TaylorHerndon/ModularI2CBoard_Spring2022/Circuit Information/SensorBoard.pdf

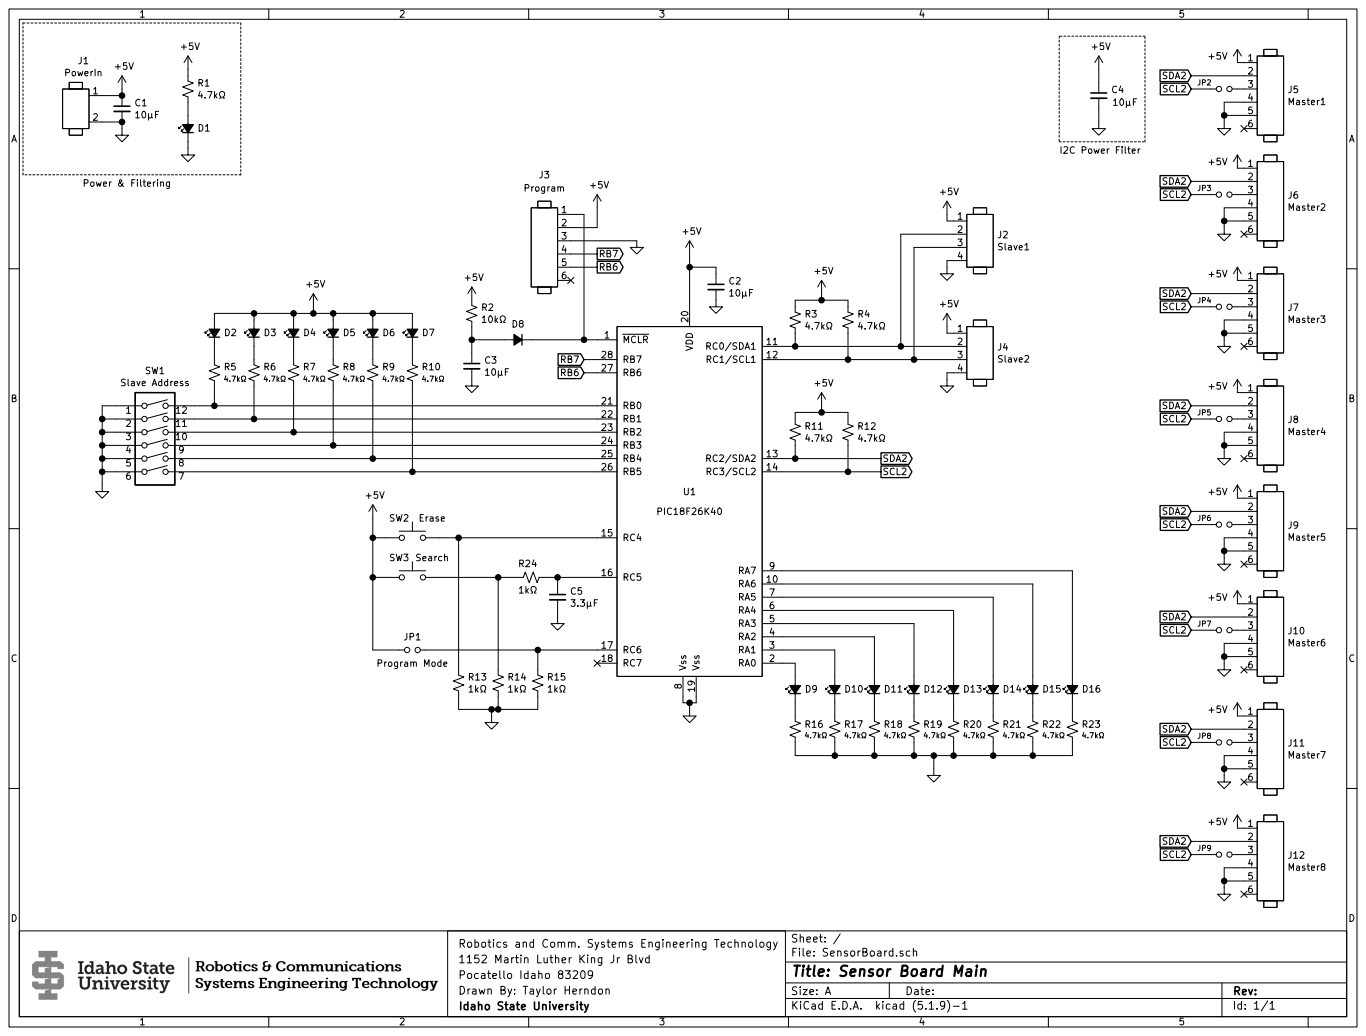
[picture p3: page 1]

I2C Power Filter Power & Filtering

File: SensorBoard.sch Sheet: /
Id: 1/1 Title: Sensor Board Main

1152 Martin Luther King Jr Blvd
Drawn By: Taylor Herndon Pocatello Idaho 83209
