TaylorHerndon/ModularI2CBoard_Spring2022/Circuit Information/SensorBoard/Back Silk Screen.pdf

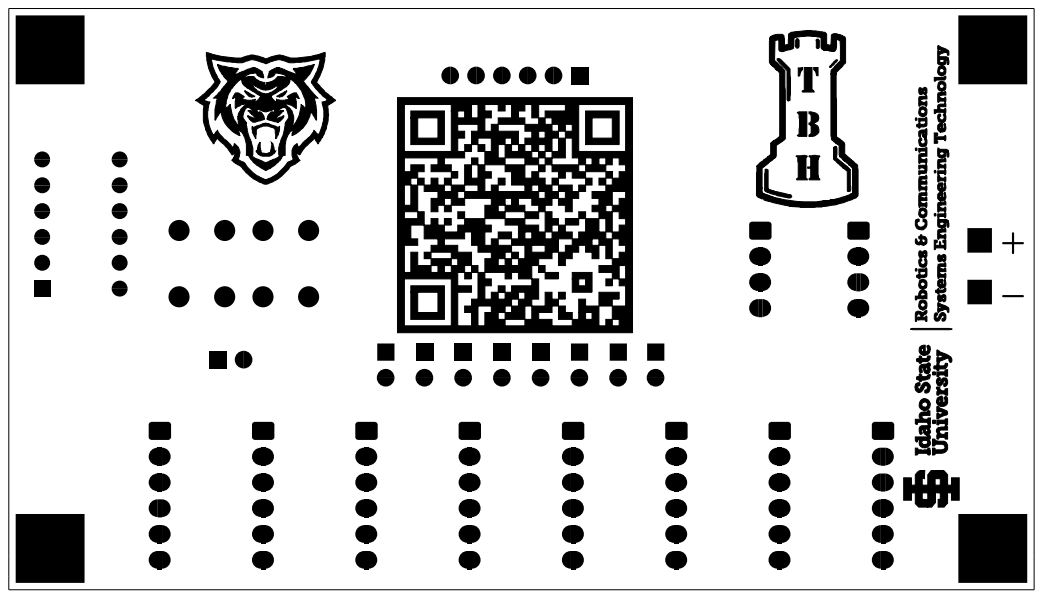
[picture p4: page 1]
