TaylorHerndon/ModularI2CBoard_Spring2022/Circuit Information/SensorBoard/Back View.pdf

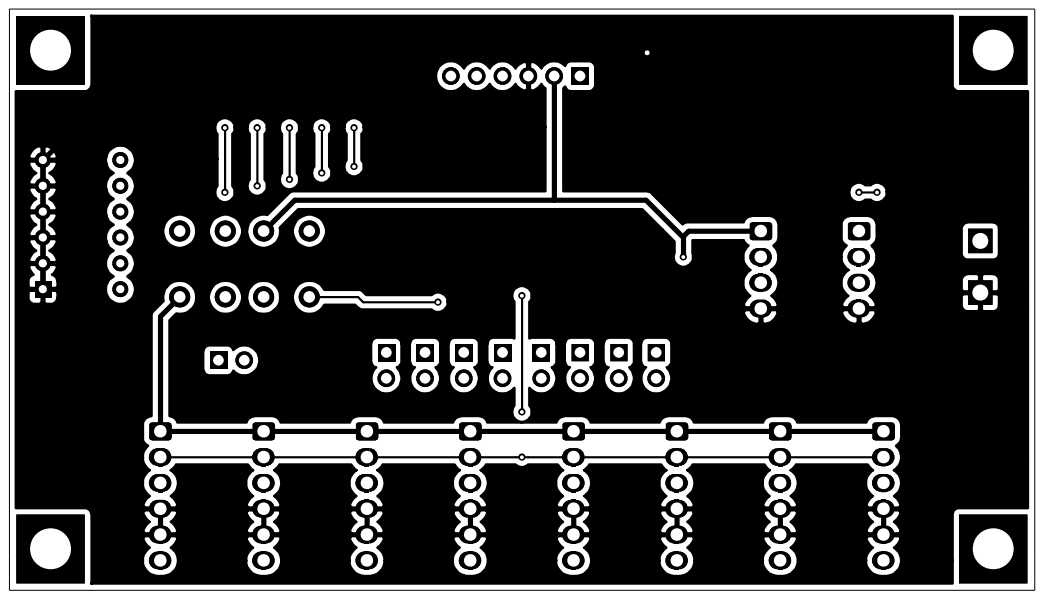
[picture p5: page 1]
