TaylorHerndon/ModularI2CBoard_Spring2022/Circuit Information/SensorBoard/Front View.pdf

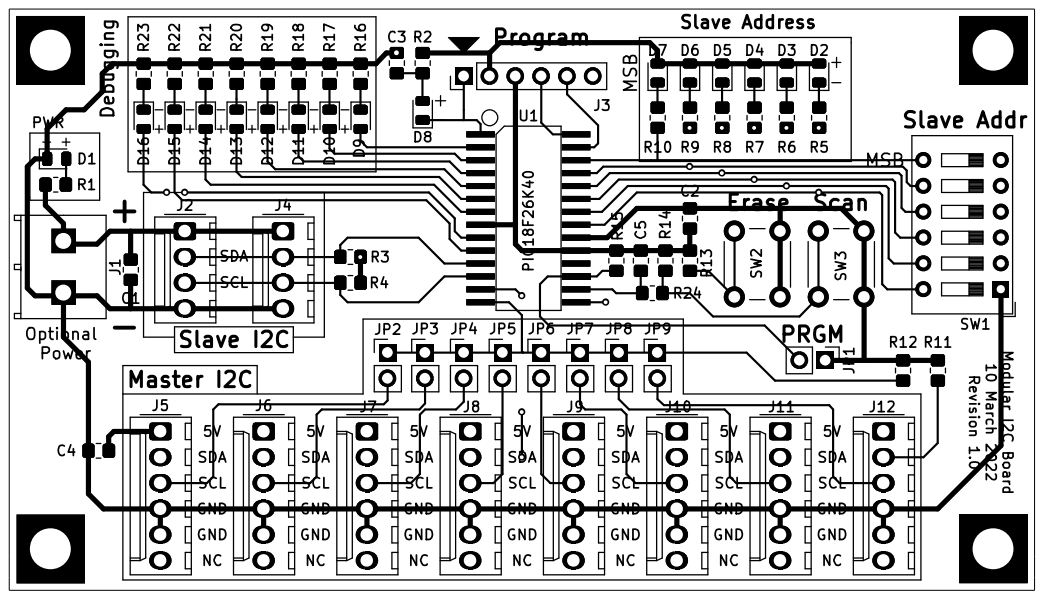
[picture p6: page 1]
