TaylorHerndon/ModularI2CBoard_Spring2022/Circuit Information/SensorBoard/SensorBoard.kicad_pcb

## KiCad design Circuit Information/SensorBoard/SensorBoard.kicad_pcb (2022-05-01)

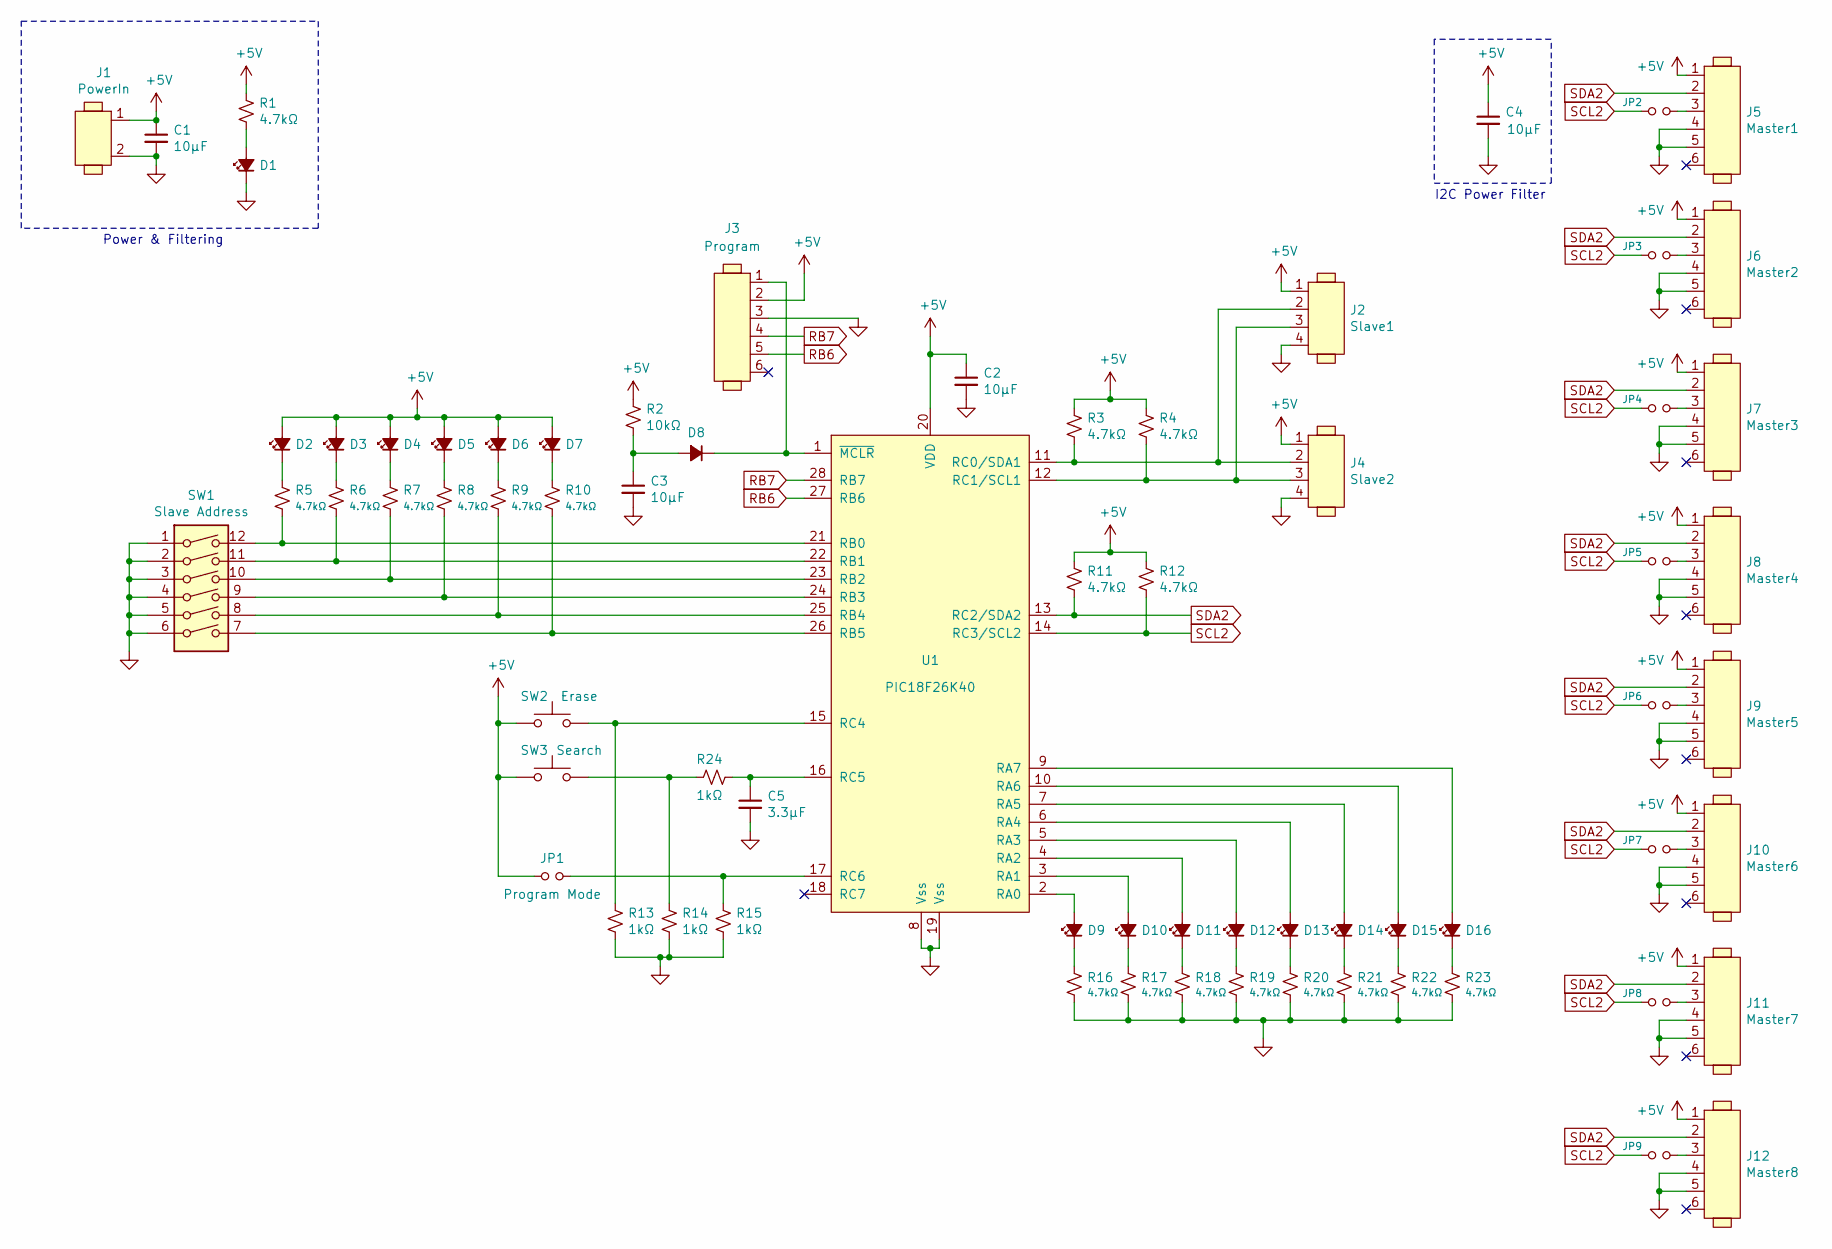
[picture p7: schematic SensorBoard.sch, Sensor Board Main]

Parts:
C1, C2, C3, C4: 10µF; R_0805_2012Metric_Pad1.20x1.40mm_HandSolder
C5: 3.3µF; R_0805_2012Metric_Pad1.20x1.40mm_HandSolder
D1, D2, D3, D4, D5, D6, D7, D9, D10, D11, D12, D13, D14, D15, D16: LED_Small_ALT; D_0805_2012Metric
D8: D_Small_ALT; D_0805_2012Metric
J1: PowerIn; 2PinScrewTerminal
J2: Slave1; Molex_KK-254_AE-6410-04A_1x04_P2.54mm_Vertical
J3: Program; PinHeader_1x06_P2.54mm_Vertical
J4: Slave2; Molex_KK-254_AE-6410-04A_1x04_P2.54mm_Vertical
J5: Master1; Molex_KK-254_AE-6410-06A_1x06_P2.54mm_Vertical
J6: Master2; Molex_KK-254_AE-6410-06A_1x06_P2.54mm_Vertical
J7: Master3; Molex_KK-254_AE-6410-06A_1x06_P2.54mm_Vertical
J8: Master4; Molex_KK-254_AE-6410-06A_1x06_P2.54mm_Vertical
J9: Master5; Molex_KK-254_AE-6410-06A_1x06_P2.54mm_Vertical
J10: Master6; Molex_KK-254_AE-6410-06A_1x06_P2.54mm_Vertical
J11: Master7; Molex_KK-254_AE-6410-06A_1x06_P2.54mm_Vertical
J12: Master8; Molex_KK-254_AE-6410-06A_1x06_P2.54mm_Vertical
JP1: Program Mode; PinHeader_1x02_P2.54mm_Vertical
JP2, JP3, JP4, JP5, JP6, JP7, JP8, JP9: Jumper_NO_Small; PinHeader_1x02_P2.54mm_Vertical
R1, R3, R4, R5, R6, R7, R8, R9, R10, R11, R12, R16, R17, R18, R19, R20, R21, R22, R23: 4.7kΩ; R_0805_2012Metric_Pad1.20x1.40mm_HandSolder
R2: 10kΩ; R_0805_2012Metric_Pad1.20x1.40mm_HandSolder
R13, R14, R15, R24: 1kΩ; R_0805_2012Metric_Pad1.20x1.40mm_HandSolder
SW1: Slave Address; SW_DIP_SPSTx06_Slide_9.78x17.42mm_W7.62mm_P2.54mm
SW2: Erase; SW_PUSH_6mm
SW3: Search; SW_PUSH_6mm
U1: PIC18F26K40; PIC18F26K40-SOIC-28

Connections:
+5V: C1.1, C2.1, C4.1, D2.2 (A), D3.2 (A), D4.2 (A), D5.2 (A), D6.2 (A), D7.2 (A), J1.1, J2.1, J3.2, J4.1, J5.1, J6.1, J7.1, J8.1, J9.1, J10.1, J11.1, J12.1, JP1.1, R1.1, R2.1, R3.1, R4.1, R11.1, R12.1, SW2.1, SW3.1, U1.20 (VDD)
GND: C1.2, C2.2, C3.2, C4.2, C5.2, D1.1 (K), J1.2, J2.4, J3.3, J4.4, J5.4, J5.5, J6.4, J6.5, J7.4, J7.5, J8.4, J8.5, J9.4, J9.5, J10.4, J10.5, J11.4, J11.5, J12.4, J12.5, R13.2, R14.2, R15.2, R16.2, R17.2, R18.2, R19.2, R20.2, R21.2, R22.2, R23.2, SW1.1, SW1.2, SW1.3, SW1.4, SW1.5, SW1.6, U1.8 (Vss), U1.19 (Vss)
unnamed: C3.1, D8.2 (A), R2.2
unnamed: C5.1, R24.2, U1.16 (RC5)
unnamed: D1.2 (A), R1.2
unnamed: D2.1 (K), R5.1
unnamed: D3.1 (K), R6.1
unnamed: D4.1 (K), R7.1
unnamed: D5.1 (K), R8.1
unnamed: D6.1 (K), R9.1
unnamed: D7.1 (K), R10.1
unnamed: D8.1 (K), J3.1, U1.1 (~MCLR)
unnamed: D9.1 (K), R16.1
unnamed: D9.2 (A), U1.2 (RA0)
unnamed: D10.1 (K), R17.1
unnamed: D10.2 (A), U1.3 (RA1)
unnamed: D11.1 (K), R18.1
unnamed: D11.2 (A), U1.4 (RA2)
unnamed: D12.1 (K), R19.1
unnamed: D12.2 (A), U1.5 (RA3)
unnamed: D13.1 (K), R20.1
unnamed: D13.2 (A), U1.6 (RA4)
unnamed: D14.1 (K), R21.1
unnamed: D14.2 (A), U1.7 (RA5)
unnamed: D15.1 (K), R22.1
unnamed: D15.2 (A), U1.10 (RA6)
unnamed: D16.1 (K), R23.1
unnamed: D16.2 (A), U1.9 (RA7)
unnamed: J2.2, J4.2, R3.2, U1.11 (RC0/SDA1)
unnamed: J2.3, J4.3, R4.2, U1.12 (RC1/SCL1)
unnamed: J5.3, JP2.2
unnamed: J6.3, JP3.2
unnamed: J7.3, JP4.2
unnamed: J8.3, JP5.2
unnamed: J9.3, JP6.2
unnamed: J10.3, JP7.2
unnamed: J11.3, JP8.2
unnamed: J12.3, JP9.2
unnamed: JP1.2, R15.1, U1.17 (RC6)
unnamed: R5.2, SW1.12, U1.21 (RB0)
unnamed: R6.2, SW1.11, U1.22 (RB1)
unnamed: R7.2, SW1.10, U1.23 (RB2)
unnamed: R8.2, SW1.9, U1.24 (RB3)
unnamed: R9.2, SW1.8, U1.25 (RB4)
unnamed: R10.2, SW1.7, U1.26 (RB5)
unnamed: R13.1, SW2.2, U1.15 (RC4)
unnamed: R14.1, R24.1, SW3.2
RB6: J3.5, U1.27 (RB6)
RB7: J3.4, U1.28 (RB7)
SCL2: JP2.1, JP3.1, JP4.1, JP5.1, JP6.1, JP7.1, JP8.1, JP9.1, R12.2, U1.14 (RC3/SCL2)
SDA2: J5.2, J6.2, J7.2, J8.2, J9.2, J10.2, J11.2, J12.2, R11.2, U1.13 (RC2/SDA2)

Notes on the sheet:
I2C Power Filter
Power & Filtering

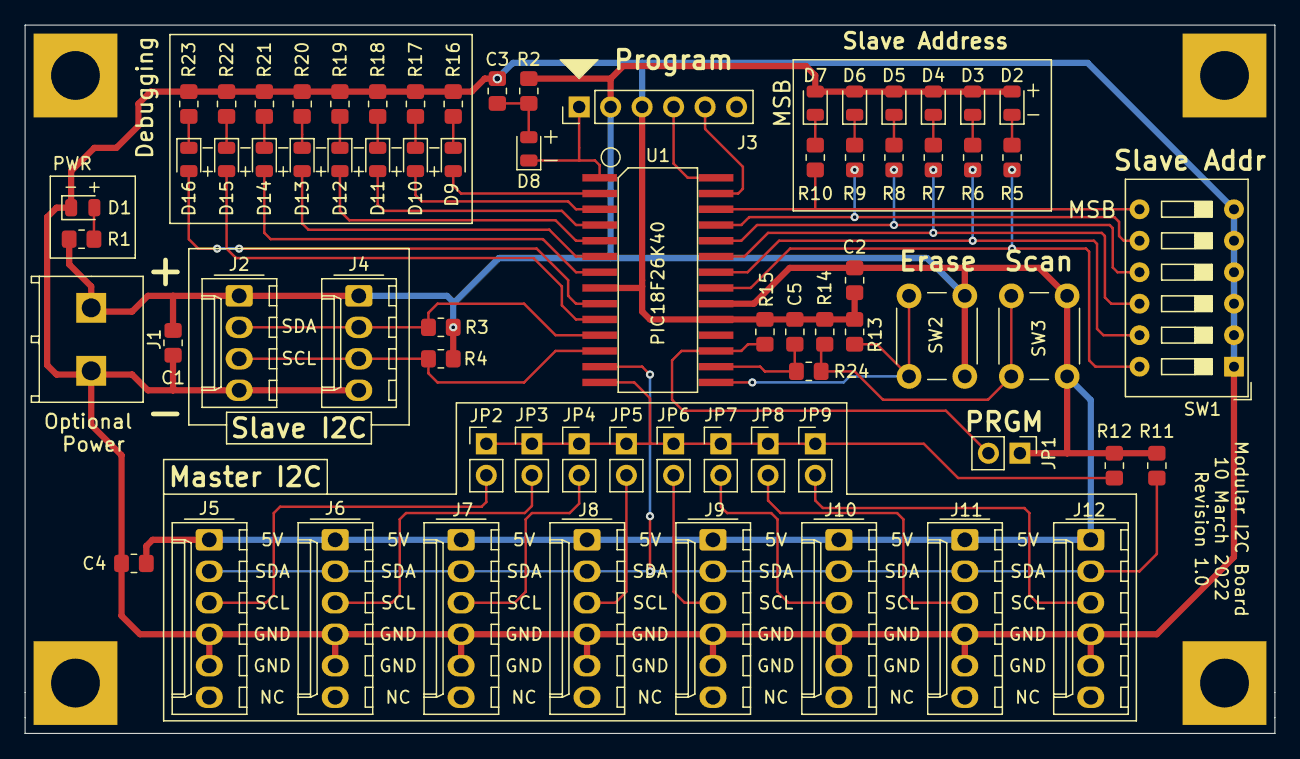
[picture p8: board SensorBoard.kicad_pcb from above]

Board: 2 copper layers, 100.8 x 57.2 mm, 70 parts (0 on the bottom side), 51 nets.
